NailsonChagas/BuckBoostCCM/imgs_sim/buckboost.png

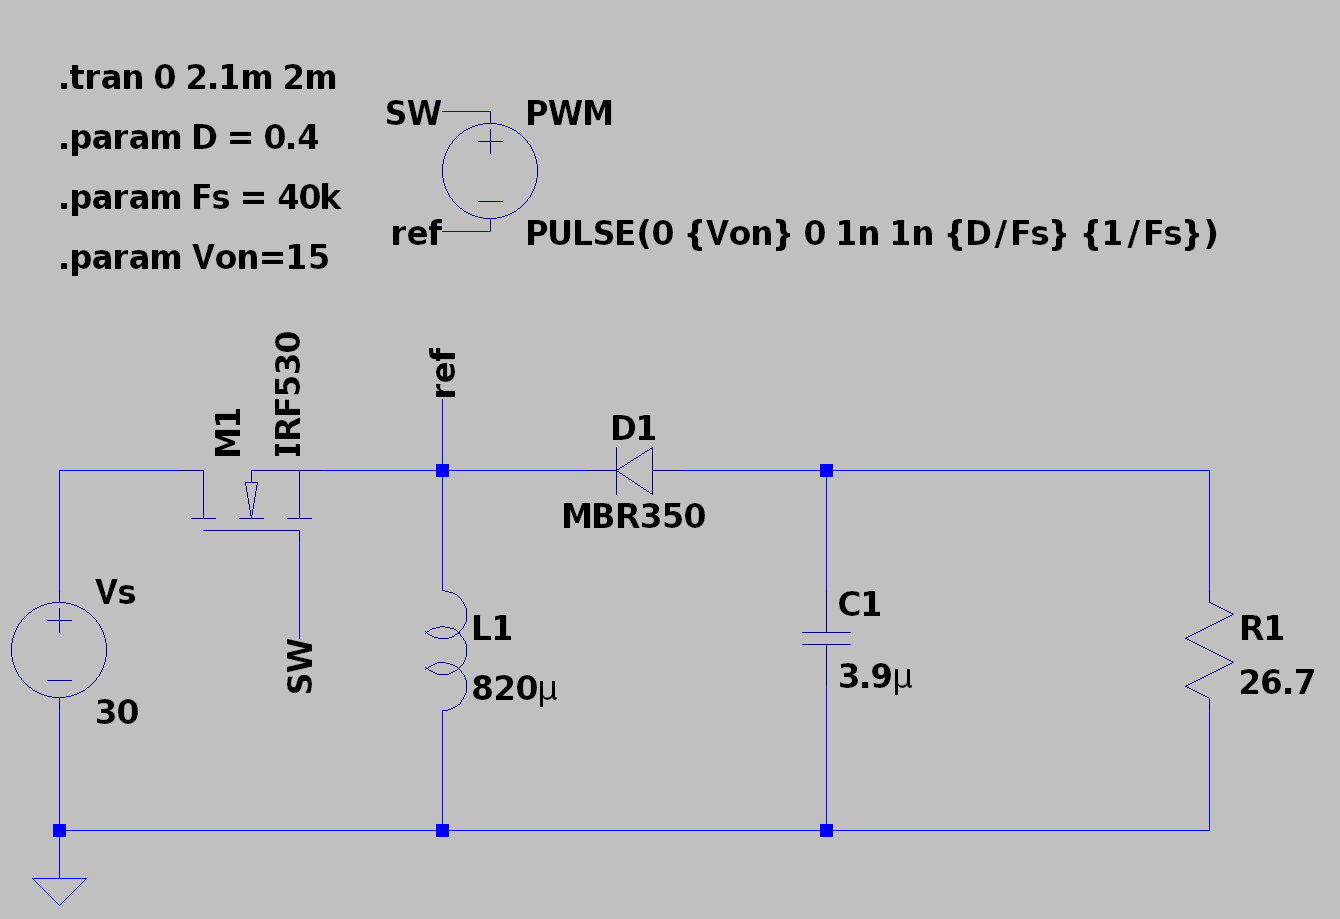
imgs_sim/buckboost.png
