NailsonChagas/BuckBoostCCM/imgs_sim/Iindutor.png

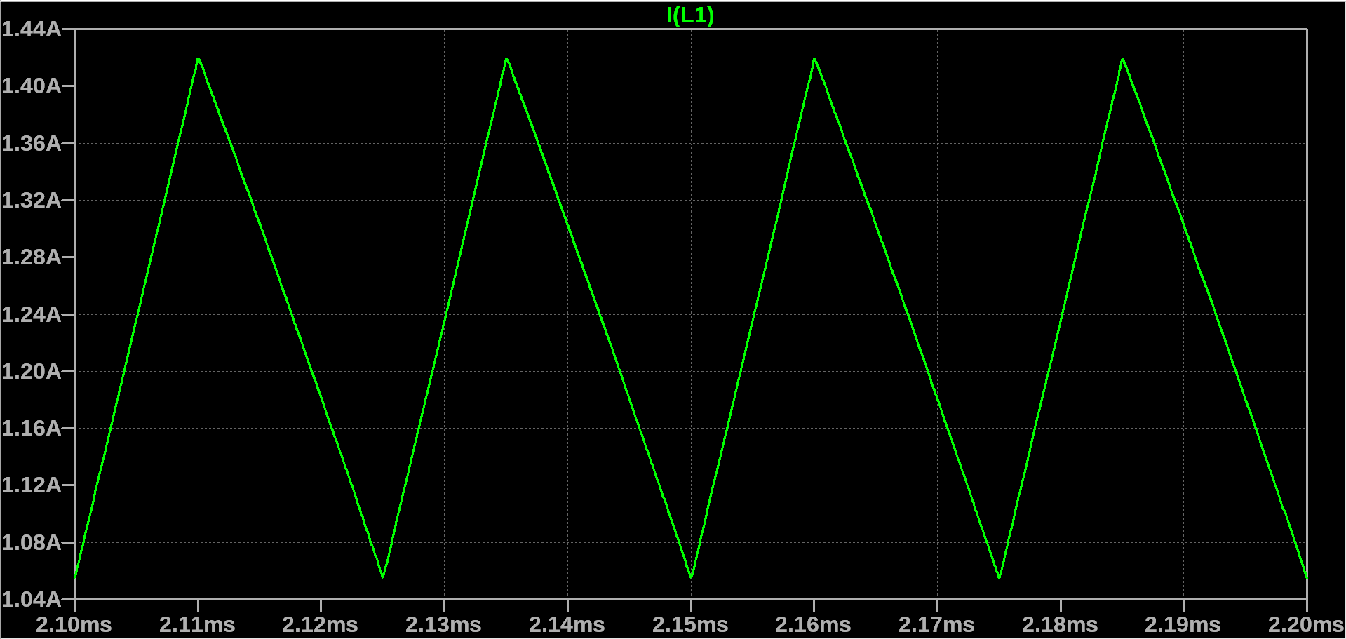
imgs_sim/Iindutor.png
