NailsonChagas/BuckBoostCCM/imgs_sim/PWM_Vgs.png

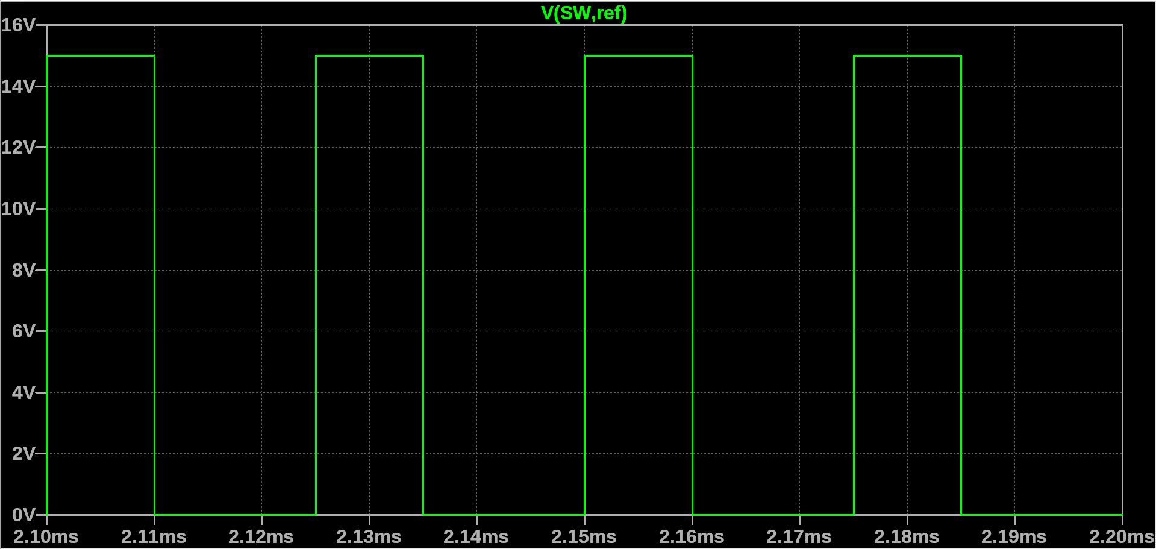
imgs_sim/PWM_Vgs.png
