NailsonChagas/BuckBoostCCM/imgs_sim/Vdiodo.png

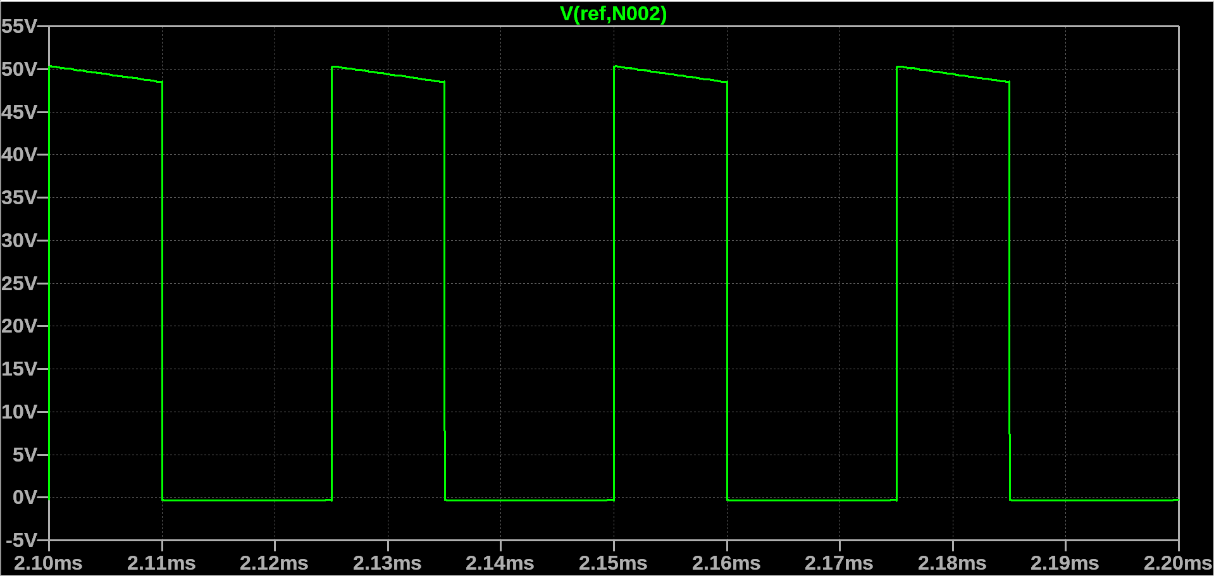
imgs_sim/Vdiodo.png
