NailsonChagas/BuckBoostCCM/imgs_sim/Vds.png

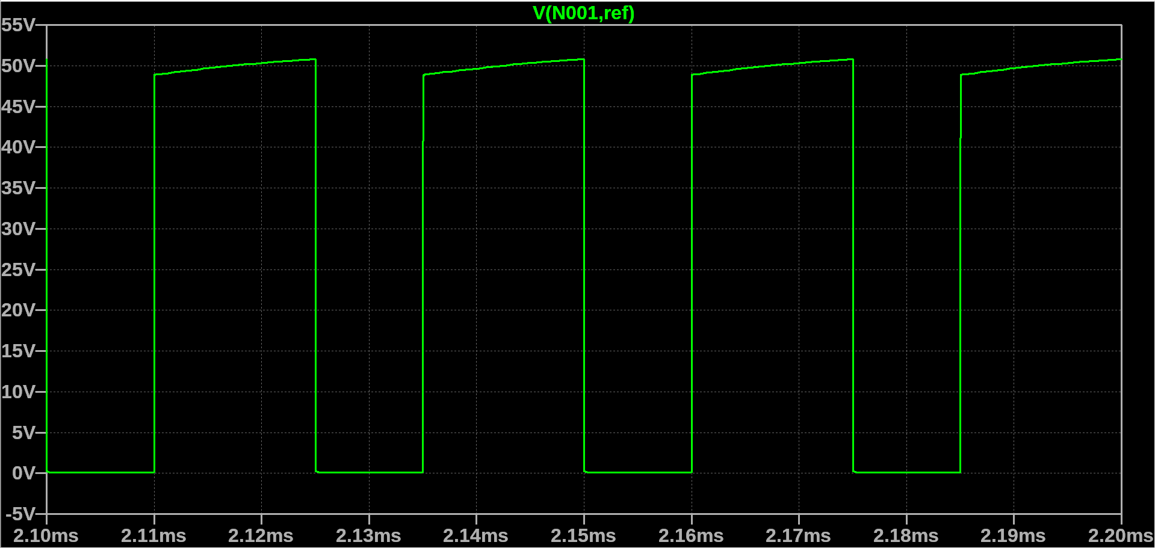
imgs_sim/Vds.png
