NailsonChagas/BuckBoostCCM/imgs_sim/Vindutor.png

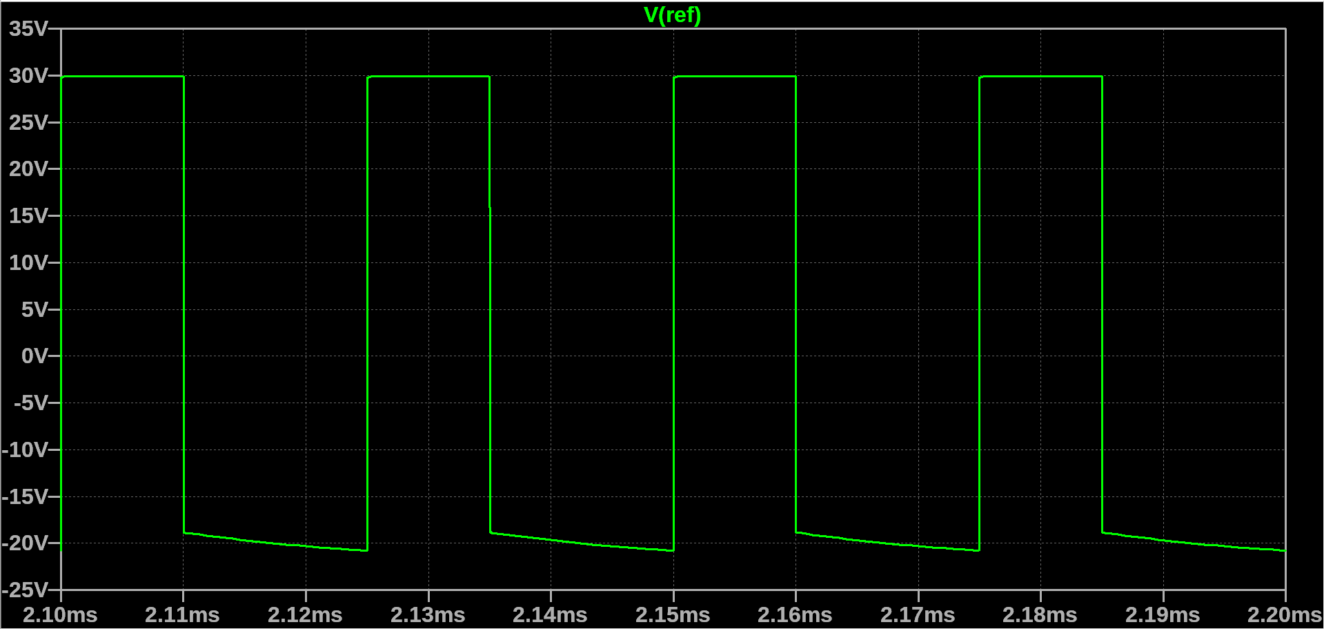
imgs_sim/Vindutor.png
