NailsonChagas/BuckBoostCCM/Simulacao/final/final_BuckBoost.asc

C1: cap; 3.9µ
C2: cap; 100n
D1: diode; MBR350
D2: diode
L1: ind; 820µ
M1: nmos; IRF530
PWM: voltage; PULSE(0 {Von} 0 1n 1n {D/Fs} {1/Fs})
R1: res; 26.7
Rg: res; 22
U1: IR2110_
V1: voltage; 15
V2: voltage; 5
Vs: voltage; 30
Named nets: SW, OUT, 0, ref
.param D = 0.4
.param Fs = 40k
.tran 0 100m 0
.param Von=3.3
.model MBR350 D(IS=50u RS=0.04 N=1.05 BV=50 IBV=10u CJO=250p VJ=0.3 M=0.33 EG=0.69 TT=10n)
.meas tran vrms_out RMS V(n002) FROM 2m TO 2.1m
.meas tran vavg_out AVG V(n002) FROM 2m TO 2.1m
.meas tran vmax_out MAX V(n002) FROM 2m TO 2.1m
.meas tran vmin_out MIN V(n002) FROM 2m TO 2.1m
 
.meas tran vrms_L RMS V(ref) FROM 2m TO 2.1m
.meas tran vavg_L AVG V(ref) FROM 2m TO 2.1m
.meas tran vmax_L MAX V(ref) FROM 2m TO 2.1m
.meas tran vmin_L MIN V(ref) FROM 2m TO 2.1m
 
.meas tran vrms_diodo RMS V(ref,n002) FROM 2m TO 2.1m
.meas tran vavg_diodo AVG V(ref,n002) FROM 2m TO 2.1m
.meas tran vmax_diodo MAX V(ref,n002) FROM 2m TO 2.1m
.meas tran vmin_diodo MIN V(ref,n002) FROM 2m TO 2.1m
 
.meas tran irms_out RMS I(R1) FROM 2m TO 2.1m
.meas tran iavg_out AVG I(R1) FROM 2m TO 2.1m
.meas tran imax_out MAX I(R1) FROM 2m TO 2.1m
.meas tran imin_out MIN I(R1) FROM 2m TO 2.1m 
 
.meas tran irms_L RMS I(L1) FROM 2m TO 2.1m
.meas tran iavg_L AVG I(L1) FROM 2m TO 2.1m
.meas tran imax_L MAX I(L1) FROM 2m TO 2.1m
.meas tran imin_L MIN I(L1) FROM 2m TO 2.1m
 
.meas tran irms_D RMS I(D1) FROM 2m TO 2.1m
.meas tran iavg_D AVG I(D1) FROM 2m TO 2.1m
.meas tran imax_D MAX I(D1) FROM 2m TO 2.1m
.meas tran imin_D MIN I(D1) FROM 2m TO 2.1m
 
.meas tran irms_C RMS I(C1) FROM 2m TO 2.1m
.meas tran iavg_C AVG I(C1) FROM 2m TO 2.1m
.meas tran imax_C MAX I(C1) FROM 2m TO 2.1m
.meas tran imin_C MIN I(C1) FROM 2m TO 2.1m
 
.meas tran irms_in RMS I(Vs) FROM 2m TO 2.1m
.meas tran iavg_in AVG I(Vs) FROM 2m TO 2.1m
.meas tran imax_in MAX I(Vs) FROM 2m TO 2.1m
.meas tran imin_in MIN I(Vs) FROM 2m TO 2.1m
