NailsonChagas/BuckBoostCCM/(commit log)

2026-06-08 feat: projeto do buck boost
2026-06-08 feat: seleção do capacitor
2026-06-08 feat: projeto do conversor buck
2026-06-08 feat: adicionando separadores para facilitar a visualição
2026-06-08 feat: adicionando seção na live script para calcular o acionamento
2026-06-08 fix: erro de formatação
2026-06-10 feat: calculo da resistencia do gate
